RahmanQureshi/8x8x8-Led-Cube/README.md

# 8x8x8 LED cube

Software and solidworks files for the control and construction of an 8x8x8 LED cube. The solidworks folder contains drawings of the base as well as construction jigs. The circuits folder contains schematics and gerber files.
