RahmanQureshi/8x8x8-Led-Cube/materials.xlsx

Part | Description | Quantity
296-1600-5-ND (http://www.digikey.com/scripts/DkSearch/dksus.dll?Detail&itemSeq=199456880&uq=636028430760750752) | IC 8-BIT SHIFT REGISTER 16-DIP | 2
296-24383-5-ND (http://www.digikey.com/scripts/DkSearch/dksus.dll?Detail&itemSeq=199456889&uq=636028430760760753) | IC LED DRIVER LINEAR 120MA 16DIP | 10
S7006-ND (http://www.digikey.com/scripts/DkSearch/dksus.dll?Detail&itemSeq=199459177&uq=636028430760760753) | CONN HEADER FEMALE 8POS .1" TIN | 2
IRF9Z34NPBF-ND (http://www.digikey.com/scripts/DkSearch/dksus.dll?Detail&itemSeq=199459424&uq=636028430760760753) | MOSFET P-CH 55V 19A TO-220AB | 10
3M5463-ND (http://www.digikey.com/scripts/DkSearch/dksus.dll?Detail&itemSeq=199463148&uq=636028430760780755) | CONN IC DIP SOCKET 16POS TIN | 10
 | RES 470 OHM 1/4W 5% | 10
 | RES 1K OHM 1/4W 5% | 50
 | HOOK-UP SOLID 20AWG BLACK 100' | 1
 | 5mm Diffused Blue LED | 600
 | Bakelite Universal Perfboard Plates | 1
 | Arduino Uno Rev 3 | 1
 | USB Cable AB | 1
 | 9 VDC 1000mA regulated switching power adapter - | 1
 | Full sized breadboard | 1
 | Assorted Jumper Wires Package | 1
