RahmanQureshi/8x8x8-Led-Cube/solidworks/panel_assembly_jig.SLDPRT

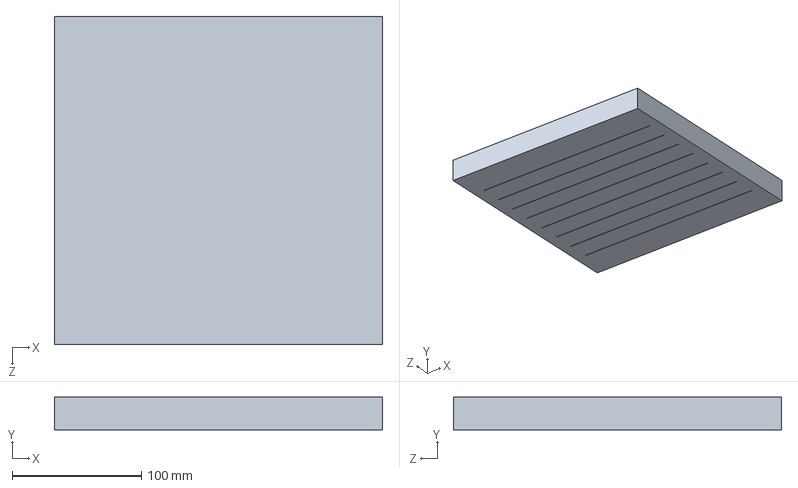
[picture p1: CAD file, 2016-08-06]
solidworks/panel_assembly_jig.SLDPRT
254.0 x 25.4 x 254.0 mm
