RahmanQureshi/8x8x8-Led-Cube/solidworks/led_row_assembly_jig.SLDPRT

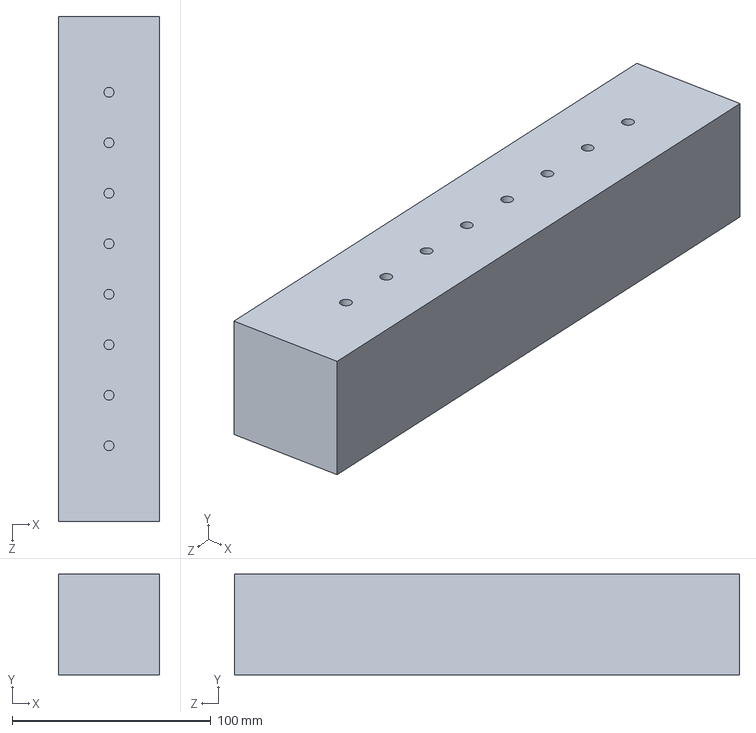
[picture p2: CAD file, 2016-08-06]
solidworks/led_row_assembly_jig.SLDPRT
50.8 x 50.8 x 254.0 mm
