RahmanQureshi/8x8x8-Led-Cube/Controller/LED Cube Gamepad (4).stl

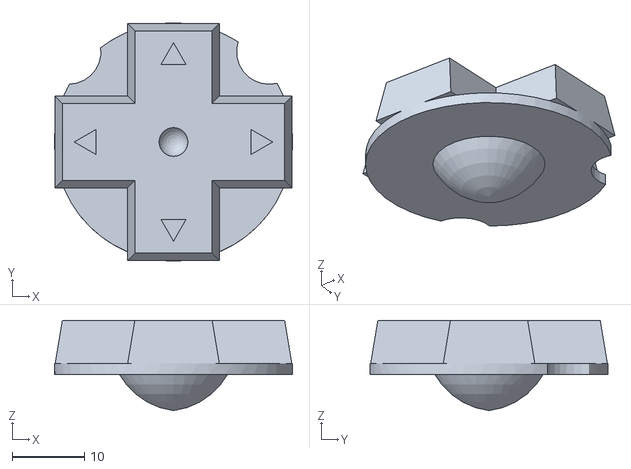
[picture p4: CAD file, 2016-08-24]
Controller/LED Cube Gamepad (4).stl
33.0 x 33.0 x 12.5
