RahmanQureshi/8x8x8-Led-Cube/solidworks/cube_base.SLDPRT

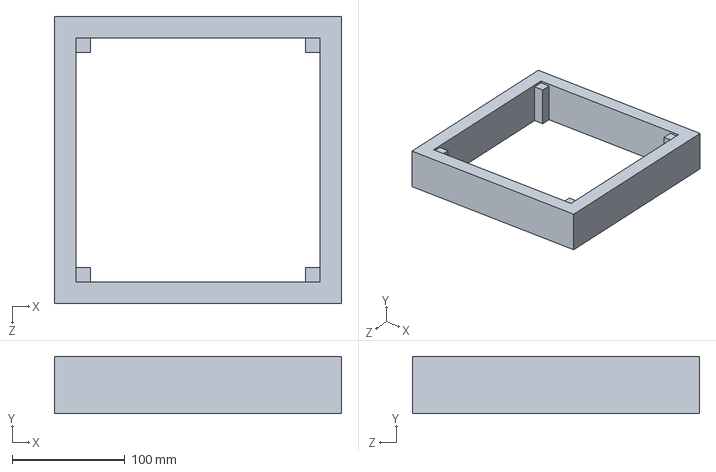
[picture p5: CAD file, 2016-08-06]
solidworks/cube_base.SLDPRT
254.0 x 50.8 x 254.0 mm
