RahmanQureshi/8x8x8-Led-Cube/solidworks/cube_base_slits.SLDPRT

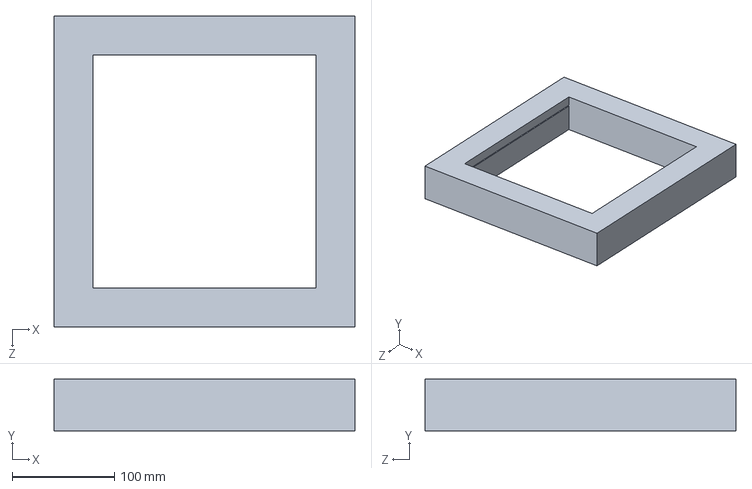
[picture p6: CAD file, 2016-08-06]
solidworks/cube_base_slits.SLDPRT
294.6 x 50.8 x 304.8 mm
