RahmanQureshi/8x8x8-Led-Cube/Controller/LED Cube Gamepad (2).stl

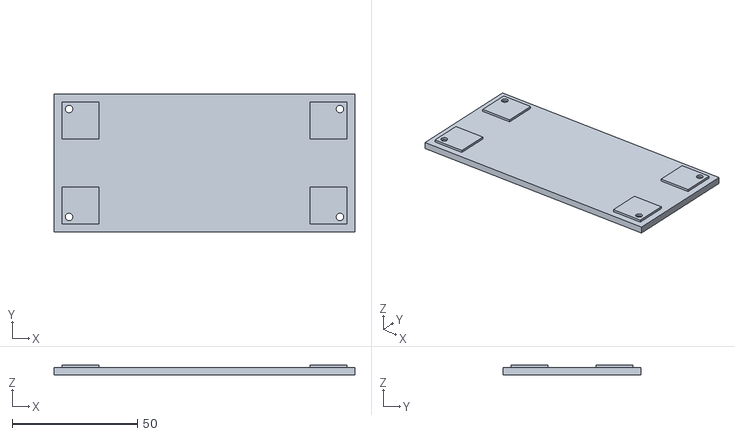
[picture p7: CAD file, 2016-08-24]
Controller/LED Cube Gamepad (2).stl
120.0 x 55.0 x 4.00
