RahmanQureshi/8x8x8-Led-Cube/Controller/LED Cube Gamepad (3).stl

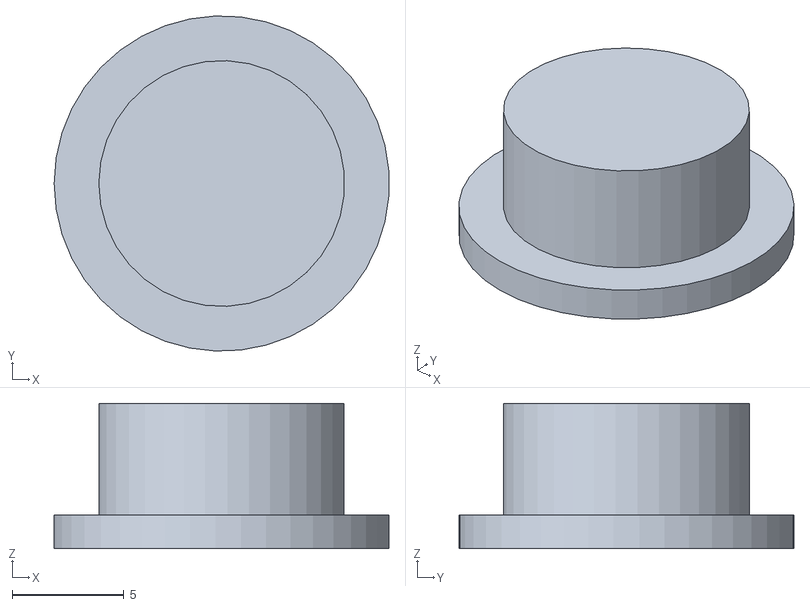
[picture p8: CAD file, 2016-08-24]
Controller/LED Cube Gamepad (3).stl
15.0 x 15.0 x 6.50
