RahmanQureshi/8x8x8-Led-Cube/(list of files, cad)

Other CAD files:
Controller/Gamepad.dwg
solidworks/cube_base.SLDDRW
solidworks/cube_base_slits.SLDDRW
solidworks/led_row_assembly_jig.SLDDRW
solidworks/panel_assembly_jig.SLDDRW
