RahmanQureshi/8x8x8-Led-Cube/circuits/8x8_LED_panel_tester_schematic.pdf

### VCC

### VCC

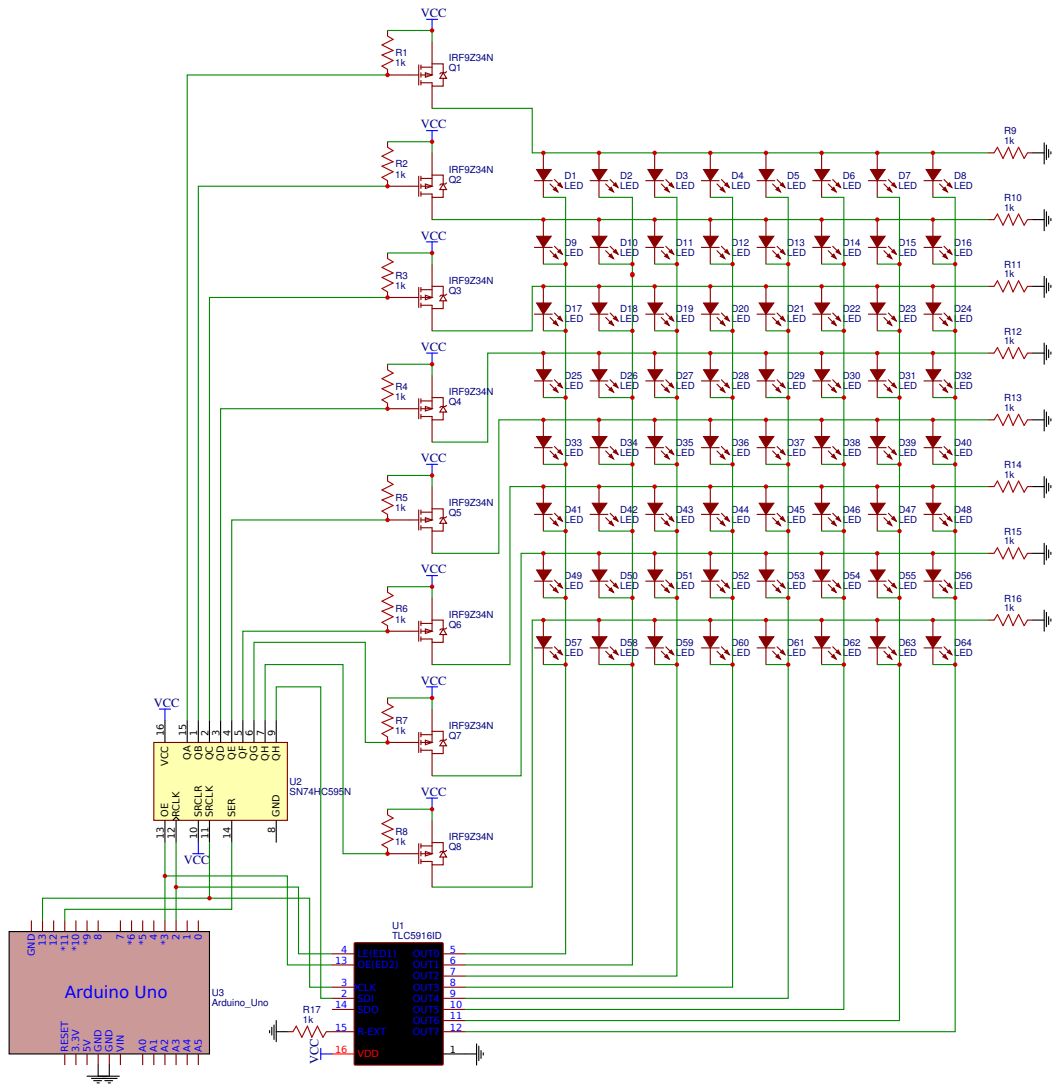
[picture p12: page 1]
