RahmanQureshi/8x8x8-Led-Cube/circuits/pcb_schematic.pdf

## VDD

## VDD

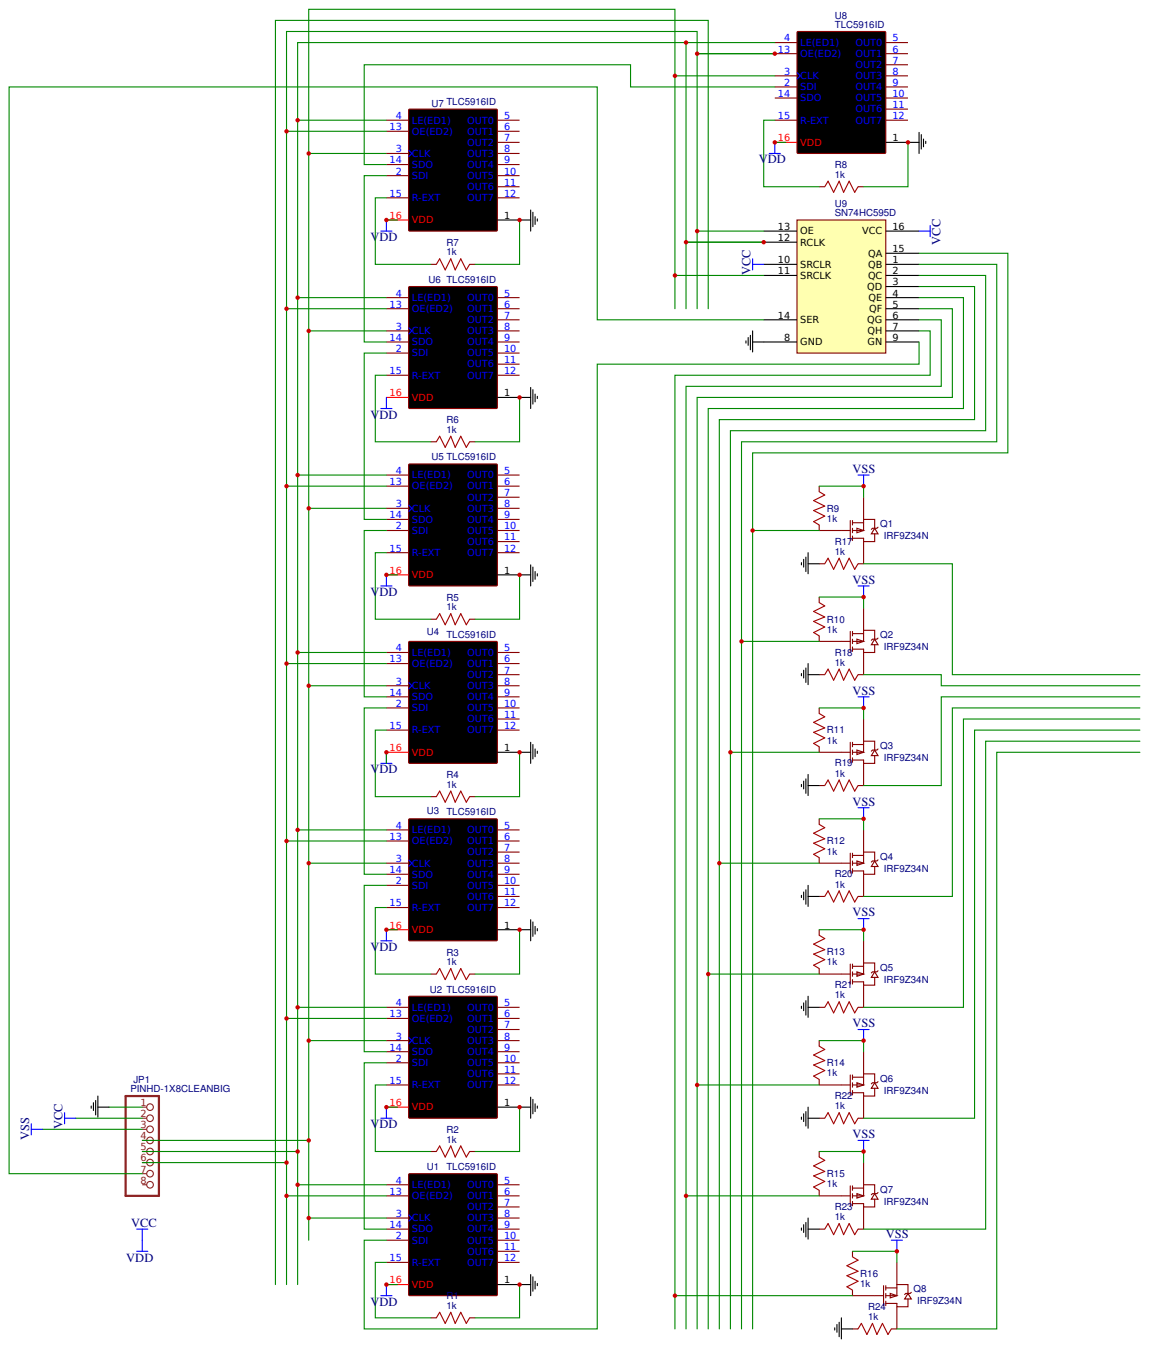
[picture p13: page 1]
