RahmanQureshi/8x8x8-Led-Cube/circuits/pcb_layout.pdf

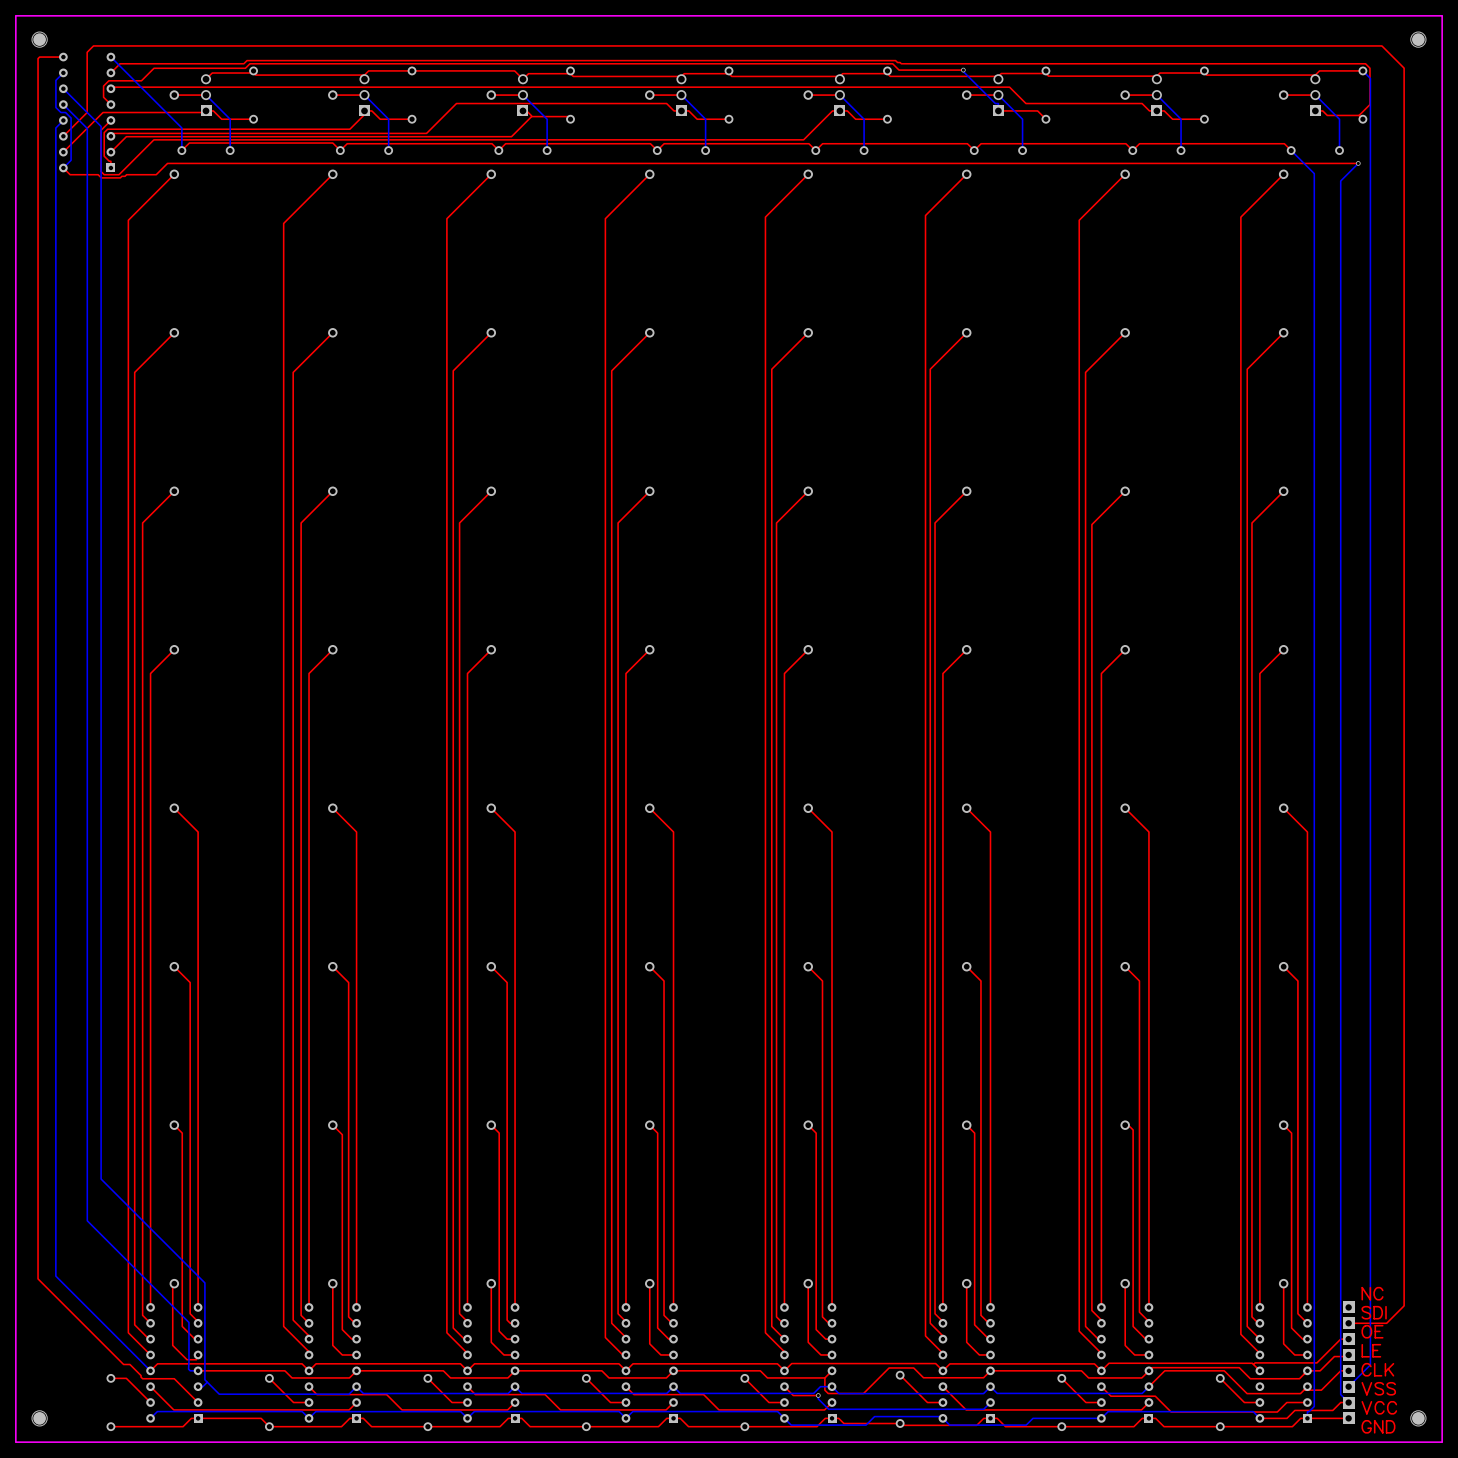
[picture p14: page 1]
