RahmanQureshi/8x8x8-Led-Cube/(commit log)

2016-08-06 Init. Software under development - rotation untested.
    [cube_base.SLDDRW, cube_base.SLDPRT, cube_base_slits.SLDDRW, cube_base_slits.SLDPRT, led_row_assembly_jig.SLDDRW, led_row_assembly_jig.SLDPRT, materials.xlsx, panel_assembly_jig.SLDDRW]
2016-08-08 fixed rotation code so that it doesn't cause arduino to crash (consuming too much memory before)
2016-08-24 Controller. Fixed LedCubeSequences N firworks and rotation.
    [Gamepad.dwg, LED Cube Gamepad (1).stl, LED Cube Gamepad (2).stl, LED Cube Gamepad (3).stl, LED Cube Gamepad (4).stl]
2016-12-18 added Makefile to auto install Arduino libraries
2016-12-21 Updated patterns and tested on cube. Fixed random functions. Fixed miniCubeDance to be more predictable which is more eye-pleasing
    [led_cube_pattern_2.ino]
